panihans/true-randomness-mainboard/README.txt

rename the directory to 'delta x mainboard' or stm32cubeide import will fail
