panihans/true-randomness-mainboard/Documentation/bom_with_order_codes.ods

Qty | TME order # | Mouser order # | Farnell Order # | Value | Device | Package
1 | * | * | 1867985 |  | Button
3 | LL-S192BC-B4-1B | 710-150060BS75000 | 2322069 |  | Blue LED | 0603
3 | FYLS-0603URC | 710-150060SS75000 | 2322072 |  | Red LED | 0603
1 | CRCW0805280RFKTABC | 667-ERJ-2RKF2800X | 2302574 | 280 | Resistor | 0402
1 | 04023C103KAT2A | 581-0402ZC103KAT2A | 2332546 | 0.01u | Capacitor | 0402
3 | C0603C223K5RAC | 80-C0603C223K5R | 1414625 | 0.022u | Capacitor | 0603
8 | C0402C104K8RAC | 80-C0402C104K8R | 2429351 | 0.1u | Capacitor | 0402
7 | 06035C104K4T2A | 581-06035C104K4 | 1301713 | 0.1u | Capacitor | 0603
1 | 06033C224KAT2A | 581-06035C224KAT2A | 2749808 | 0.22u | Capacitor | 0603
1 | CRCW060312K0FKEA | 71-CRCW0603-1.8K-E3 | 1652854 | 1.8k | Resistor | 0603
2 | AC0603FR-07100RL | 603-AC0603FR-07100RL | 3495223 | 100 | Resistor | 0603
3 | CK1H107M08010VR | 710-865060653010 | 2466235 | 100 µF | Electrolytic capacitor | Ø8x10mm
2 | CRCW0603100KFKEA | 71-CRCW0603-100K-E3 | 1469649 | 100k | Resistor | 0603
4 | 1210B106K500CT | 581-12105C106K4T2A | 2834943 | 10u | Capacitor | 1210
1 | DE1207-15 | 710-7447709150 | 1635944 | 15uH | Inductor | 1210
1 | C0603C105K8RAC | 80-C0603C105K8R | 2522396 | 1u | Capacitor | 0603
1 | 08055C105KAT2A | 581-08055C105K4T2A | 2479893 | 1u | Capacitor | 0805
1 | 0603X225K100CT | 810-C1608X7R1A225K | 2346896 | 2.2u | Capacitor | 0603
3 | CQ0603-2K7-1% | 755-ESR03EZPF2701 | 2694062 | 2.7k | Resistor | 0603
3 | 0603SAF2002T5E | 279-CPF0603F20KC1 | 1527615 | 20k | Resistor | 0603
8 | 7-215079-4 | 571-215079-4 | 1772996 | 215079-4 | Connector | 215079-4
1 | CRCW060324K9FKTABC | 279-CPF0603F24K9C1 | 1527625 | 24.9k | Resistor | 0603
3 | CRCW06033K90FKTABC | 652-CR0603-FX3901ELF | 2908301 | 3.9k | Resistor | 0603
1 | C0603C475K8PAC | 80-C0603C475K8P | 1572625 | 4.7u | Capacitor | 0603
2 | CL21A475KBQNNNE | 810-CGA4J1X7R1H475K2 | 3228181 | 4.7u | Capacitor | 0805
3 | GRM32ER71A476KE15L | 81-GRM32ER71A476KE5L | 1797018 | 47u | Capacitor | 1210
3 | AC0603JR-0756KL | 652-CR0603FX-5602ELF | 2908323 | 56k | Resistor | 0603
1 | * | 710-824011 | 1748616 | 5Vdc | TVS-Diode | SOT23-5L
1 | * | 710-629105150521 | 2470822 | 629105150521 | Micro USB connector
1 | * | 771-BUK6Y10-30PX | 3438512 | BUK6Y10-30P | Power MOSFET | LFPAK56
3 | * | 595-DRV8874QPWPRQ1 | * | DRV8874 | Motor driver | HTSSOP-16
1 | * | 200-FTSH10501LDVK | 2856437 | FTSH-105-01-XXX-DV-K | Programmer connector
1 | * | 595-LMR36520ADDAR | * | LMR36520ADDAR | Switching regulator | HSOIC-8
1 | 67996-206HLF | 649-67996-406HLF | 2751377 | PINHD-2X3 | Pin header | 2x3
2 | * | 634-SI8660BB-B-IU | 3105912 | SI8660BB-IU | Digital isolator | QSOP-16
1 | * | 511-STM32G431KBT6 | 3132405 | STM32G431KB | Microcontroller | LQFP-32
1 | TLV70233DBVR | 595-TLV70233DBVR | 3007784 | TLV702 | Regulator 5V→3.3V | SOT23-5
4 | * | 538-172286-1102 | 2494345 | ULTRA-FIT-2PIN | Molex connector receptacle | 2x1
1 | TSHG8200 | 782-TSHG8200 | 1779682 |  | IR diode | THT
1 | IS471FE | 852-IS471FE | 9707840 |  | IR receiver | THT
8 | AMP-7-215083-4 | 571-215083-4 | 149032 |  | micro match housing | 2x2
8 | 7-215079-4 | 571-215079-4 | 1772996 |  | micro match receptacle | 2x2
1 | 1-880584-2 | 571-880584-4 | 1654804 |  | jumper | 2x1
4 | * | 538-172256-3102 | 3225241 |  | Molex connector housing | 2x1
8 | * | 538-172253-7023 | 3220453 | 16-18awg, tin | Crimp terminal
