panihans/true-randomness-mainboard/Documentation/board.pdf

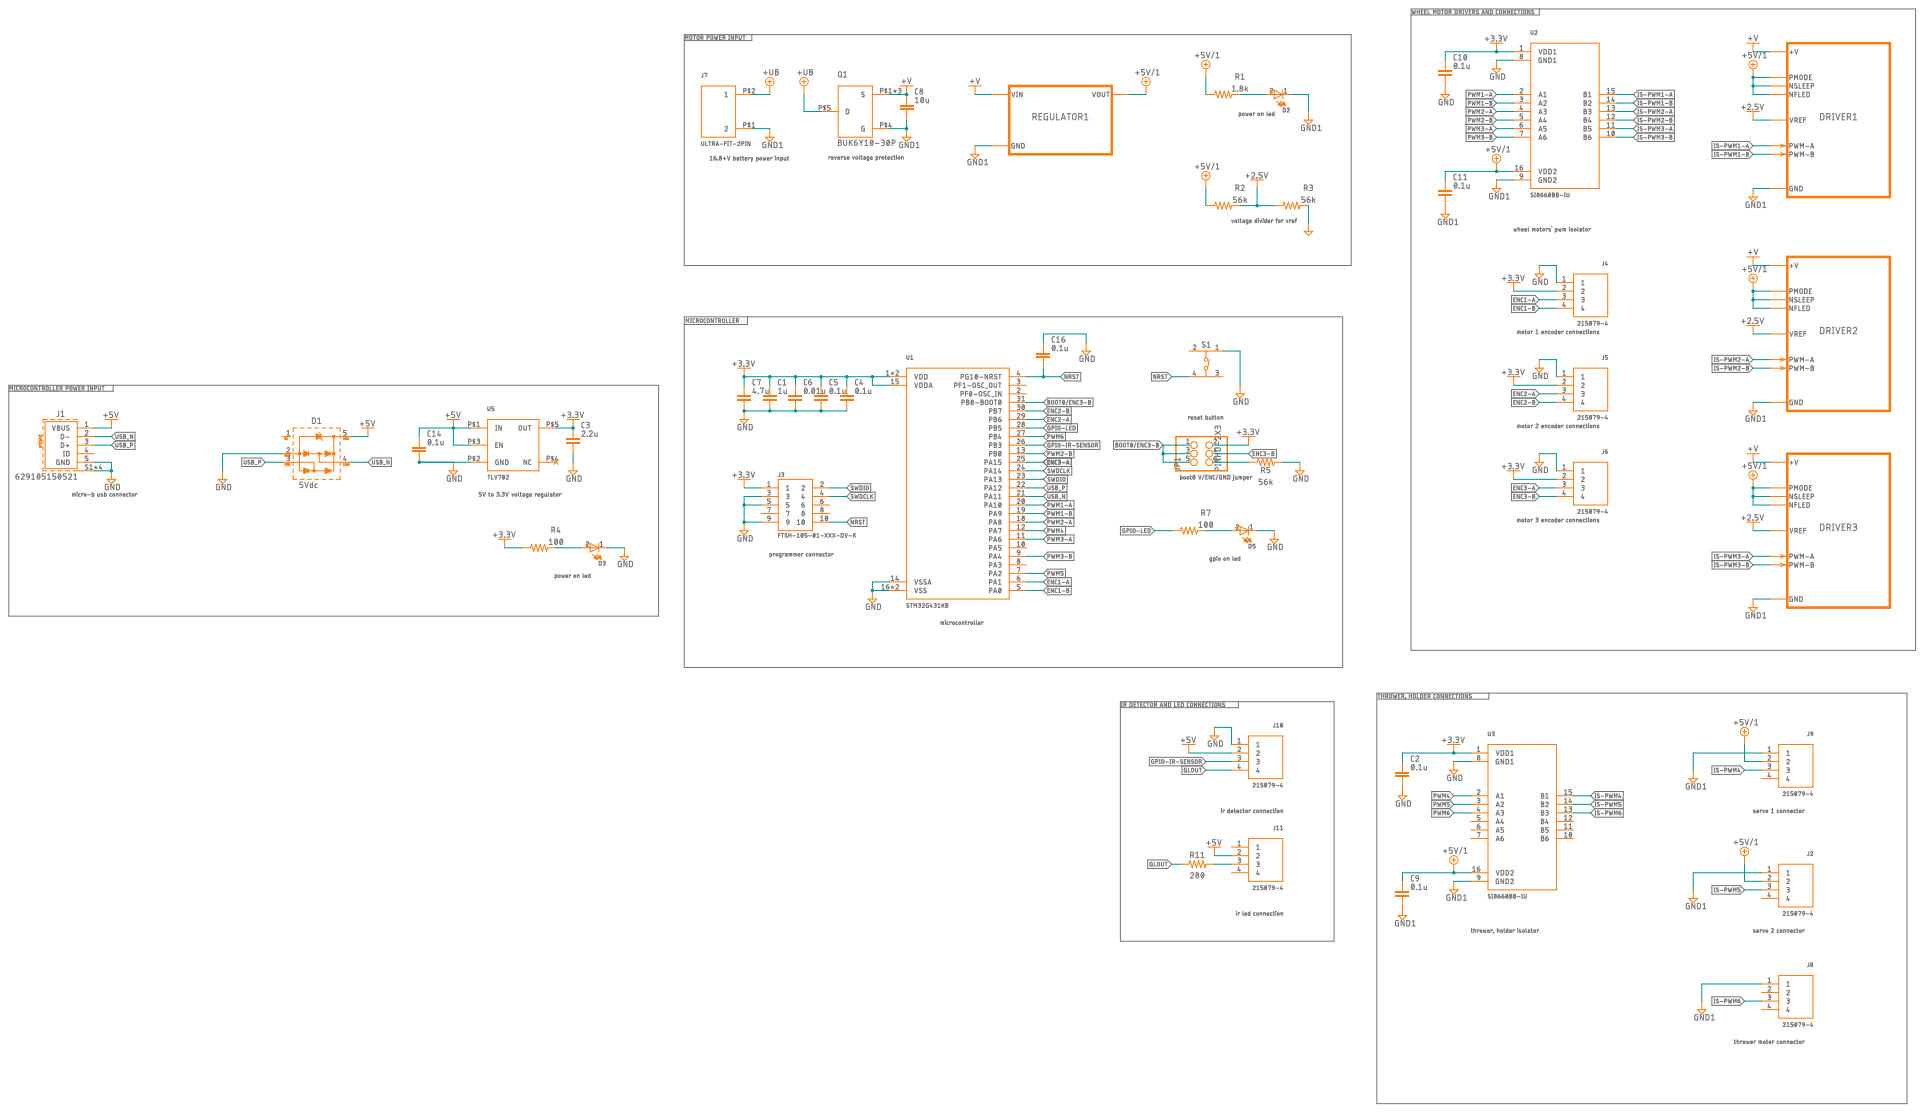
[picture p1: page 1]
