panihans/true-randomness-mainboard/Documentation/regulator.pdf

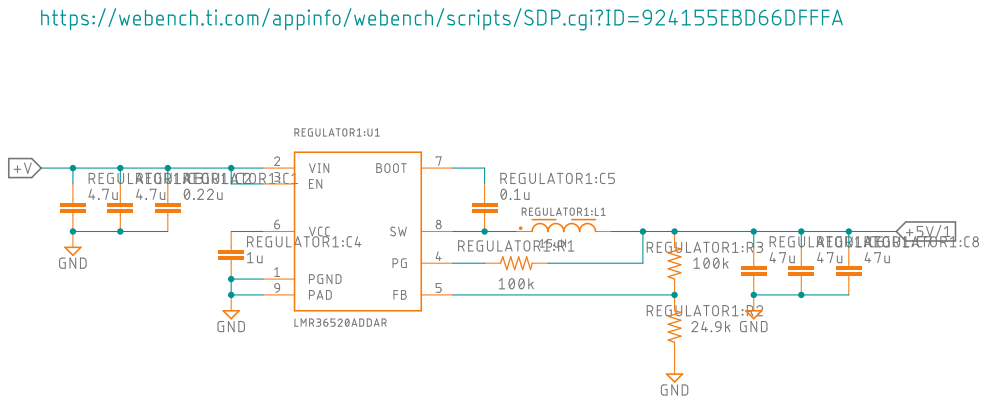
[picture p5: page 1]
