panihans/true-randomness-mainboard/Core/Src/main.c

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
/* Includes ------------------------------------------------------------------*/
#include "main.h"
#include "usb_device.h"

TIM_HandleTypeDef htim1;
TIM_HandleTypeDef htim2;
TIM_HandleTypeDef htim3;
TIM_HandleTypeDef htim4;
TIM_HandleTypeDef htim7;
TIM_HandleTypeDef htim8;
TIM_HandleTypeDef htim15;
TIM_HandleTypeDef htim16;
TIM_HandleTypeDef htim17;

void SystemClock_Config(void);
static void MX_GPIO_Init(void);
static void MX_TIM4_Init(void);
static void MX_TIM8_Init(void);
static void MX_TIM15_Init(void);
static void MX_TIM16_Init(void);
static void MX_TIM1_Init(void);
static void MX_TIM2_Init(void);
static void MX_TIM3_Init(void);
static void MX_TIM7_Init(void);
static void MX_TIM17_Init(void);
/* USER CODE BEGIN 0 */

typedef struct Command {
	float motor1;
	float motor2;
	float motor3;
	float thrower;
	float servo;
	int32_t ir;
	float pGain;
	float iGain;
	float dGain;
	int32_t pid_type;
	int32_t delimiter;
} Command;

Command command, feedback;

volatile uint8_t command_received = 0;
volatile uint8_t command_received_ticker = 0;

volatile float pGain, iGain, dGain = 0;

void CDC_On_Receive(uint8_t *buffer, uint32_t *length) {
	if (*length == sizeof(Command)) {
		memcpy(&command, buffer, sizeof(Command));

		if (command.delimiter == 0xABCABC) {
			command_received = 1;
		}
	}
}

inline void Set_Motor_Speed_f(volatile uint32_t *channel_a,
		volatile uint32_t *channel_b, float motor_speed) {
	if (fabs(0 - motor_speed) > 0.1) {
		if (motor_speed > 0) {
			// forward
			if (motor_speed > 100) {
				motor_speed = 100;
			}
			*channel_a = motor_speed * 65000.0 / 100.0;
			*channel_b = 0;
		} else if (motor_speed < 0) {
			// backward
			if (motor_speed < -100) {
				motor_speed = -100;
			}
			*channel_b = motor_speed * -(65000.0 / 100.0);
			*channel_a = 0;
		}
	} else {
		// stop
		*channel_a = 0;
		*channel_b = 0;
	}
}

inline void Set_Thrower_Speed(volatile uint32_t *channel_a, float thrower_speed) {
	if (thrower_speed > 0) {
		// forward
		if (thrower_speed <= ESC_MAX_SPEED) {
			// 0 to 100 compact range
			*channel_a = thrower_speed * ESC_CO + ESC_MIN_CCR;
		}
	} else {
		// stop
		*channel_a = ESC_IDLE_CCR;
	}
}

inline void Set_Servo_Speed(volatile uint32_t *channel_a, float servo_speed,
		GPIO_PinState ir_status, int32_t ir_control) {
	if (!ir_status || (ir_status && ir_control)) {
		if (servo_speed > 0 && servo_speed <= SERVO_MAX_SPEED) {
			*channel_a = SERVO_IN_MIN_CCR - command.servo * SERVO_CO;
		} else if (command.servo < 0 && servo_speed >= -SERVO_MAX_SPEED) {
			*channel_a = command.servo * -SERVO_CO + SERVO_OUT_MIN_CCR;
		} else {
			*channel_a = 0;
		}
	}
}

Motor motor1;
Motor motor2;
Motor motor3;

inline void Calculate_PID(Motor *motor) {
// based on "PID Without a PhD" by Tim Wescott
// https://www.embeddedrelated.com/showarticle/943.php
	if (motor->target_speed > 0.1 || motor->target_speed < -0.1) {
		float pTerm, iTerm, dTerm;
//		if (command.pid_type == 0) {
//			pGain = 1;
//			iGain = 0.005;
//			dGain = 5;
//		} else {
//			pGain = 1;
//			iGain = 0.001;
//			dGain = 10;
//		}
		pGain = command.pGain;
		iGain = command.iGain;
		dGain = command.dGain;

		int error = 0;
		if (command.pid_type == 0) {
			error = motor->target_speed - motor->cur_enc_speed;
		} else {
			error = motor->target_speed - motor->enc_speed_hist_avg;
		}
		pTerm = error * pGain;

		motor->err_sum += error;
		motor->err_sum = clamp(-1000, 1000, motor->err_sum);
		iTerm = iGain * motor->err_sum;

		dTerm = dGain * (motor->prev_speed - motor->cur_enc_speed);
		motor->prev_speed = motor->cur_enc_speed;
		motor->cur_speed = motor->cur_speed + pTerm + iTerm + dTerm;
		motor->cur_speed = clamp(-100, 100, motor->cur_speed);
	} else {
		motor->cur_speed = 0;
	}
}

inline int Calculate_Encoder_Diff(uint16_t prev_pos, uint16_t cur_pos) {
	int diff = 0;
	if (prev_pos > ENCODER_QUADRANT_3 && cur_pos < ENCODER_QUADRANT) {
		// encoder counter overflow from high to low
		diff = 65535 - prev_pos + cur_pos;
	} else if (prev_pos < ENCODER_QUADRANT && cur_pos > ENCODER_QUADRANT_3) {
		// encoder counter overflow from low to high
		diff = -65535 + cur_pos - prev_pos;
	} else {
		// encoder didn't overflow
		diff = cur_pos - prev_pos;
	}
	return diff;	// clamp(-200, 200, diff) / 2;
}

void Handle_Encoder(Motor *motor, uint16_t count) {
	motor->cur_pos = count;
	motor->cur_enc_speed = Calculate_Encoder_Diff(motor->prev_pos,
			motor->cur_pos);
	motor->prev_pos = motor->cur_pos;

	motor->enc_speed_hist[motor->enc_speed_hist_cnt] = motor->cur_enc_speed;
	if (motor->enc_speed_hist_cnt >= 9) {
		motor->enc_speed_hist_cnt = 0;
	} else {
		motor->enc_speed_hist_cnt += 1;
	}

	int sum = 0;
	for (int i = 0; i < 10; i++) {
		sum += motor->enc_speed_hist[i];
	}
	motor->enc_speed_hist_avg = sum / 10;
}

/* USER CODE END 0 */

/**
 * @brief  The application entry point.
 * @retval int
 */
int main(void) {
	/* MCU Configuration--------------------------------------------------------*/

	/* Reset of all peripherals, Initializes the Flash interface and the Systick. */
	HAL_Init();

	/* Configure the system clock */
	SystemClock_Config();

	/* Initialize all configured peripherals */
	MX_GPIO_Init();
	MX_TIM4_Init();
	MX_TIM8_Init();
	MX_TIM15_Init();
	MX_TIM16_Init();
	MX_TIM1_Init();
	MX_TIM2_Init();
	MX_TIM3_Init();
	MX_TIM7_Init();
	MX_TIM17_Init();
	MX_USB_Device_Init();
	/* USER CODE BEGIN 2 */

	HAL_TIM_Encoder_Start(&htim2, TIM_CHANNEL_1 | TIM_CHANNEL_2);
	HAL_TIM_Encoder_Start(&htim4, TIM_CHANNEL_1 | TIM_CHANNEL_2);
	HAL_TIM_Encoder_Start(&htim8, TIM_CHANNEL_1 | TIM_CHANNEL_2);

	HAL_TIM_PWM_Start(&htim1, TIM_CHANNEL_1);
	HAL_TIM_PWM_Start(&htim1, TIM_CHANNEL_2);
	HAL_TIM_PWM_Start(&htim1, TIM_CHANNEL_3);
	TIM1->CCR1 = 0;
	TIM1->CCR2 = 0;
	TIM1->CCR3 = 0;

	HAL_TIM_PWM_Start(&htim3, TIM_CHANNEL_1);
	HAL_TIM_PWM_Start(&htim3, TIM_CHANNEL_2);
	HAL_TIM_PWM_Start(&htim3, TIM_CHANNEL_3);
	TIM3->CCR1 = 0;
	TIM3->CCR2 = 0;
	TIM3->CCR3 = 0;

	HAL_TIM_PWM_Start(&htim15, TIM_CHANNEL_1);
	HAL_TIM_PWM_Start(&htim16, TIM_CHANNEL_1);
	HAL_TIM_PWM_Start(&htim17, TIM_CHANNEL_1);
	TIM15->CCR1 = 0;
	TIM16->CCR1 = ESC_IDLE_CCR;
	TIM17->CCR1 = 0;

	HAL_TIM_Base_Start_IT(&htim7);

	CoreDebug->DEMCR |= CoreDebug_DEMCR_TRCENA_Msk;
	DWT->CYCCNT = 0;
	DWT->CTRL |= DWT_CTRL_CYCCNTENA_Msk;

	/* USER CODE END 2 */

	/* Infinite loop */
	/* USER CODE BEGIN WHILE */
	while (1) {
		/* USER CODE END WHILE */

		/* USER CODE BEGIN 3 */
		if (command_received == 1) {
			command_received = 0;
			command_received_ticker = 140;

			// toggle led
			HAL_GPIO_TogglePin(GPIOB, GPIO_PIN_5);

			feedback.ir = HAL_GPIO_ReadPin(GPIOB, GPIO_PIN_3);

			if (fabs(0 - command.motor1) < 0.1) {
				motor1.err_sum = 0;
			}
			if (fabs(0 - command.motor2) < 0.1) {
				motor2.err_sum = 0;
			}
			if (fabs(0 - command.motor3) < 0.1) {
				motor3.err_sum = 0;
			}
			motor1.target_speed = command.motor1;
			motor2.target_speed = command.motor2;
			motor3.target_speed = command.motor3;
//			pGain = command.pGain;
//			iGain = command.iGain;
//			dGain = command.dGain;

			Set_Thrower_Speed(&(TIM16->CCR1), command.thrower);

			Set_Servo_Speed(&(TIM17->CCR1), command.servo,
					HAL_GPIO_ReadPin(GPIOB, GPIO_PIN_3), command.ir);

			CDC_Transmit_FS(&feedback, sizeof(feedback));
		}
	}
	/* USER CODE END 3 */
}

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
/* USER CODE BEGIN 4 */
void HAL_TIM_PeriodElapsedCallback(TIM_HandleTypeDef *htim) {
//	unsigned long t1 = DWT->CYCCNT;

	Handle_Encoder(&motor1, TIM2->CNT);
	Handle_Encoder(&motor2, TIM4->CNT);
	Handle_Encoder(&motor3, TIM8->CNT);
	if (command.pid_type == 0) {
		feedback.motor1 = motor1.cur_enc_speed;
		feedback.motor2 = motor2.cur_enc_speed;
		feedback.motor3 = motor3.cur_enc_speed;
	} else {
		feedback.motor1 = motor1.enc_speed_hist_avg;
		feedback.motor2 = motor2.enc_speed_hist_avg;
		feedback.motor3 = motor3.enc_speed_hist_avg;
	}

	Calculate_PID(&motor1);
	Calculate_PID(&motor2);
	Calculate_PID(&motor3);
	Set_Motor_Speed_f(&(TIM1->CCR2), &(TIM1->CCR3), motor1.cur_speed);
	Set_Motor_Speed_f(&(TIM1->CCR1), &(TIM3->CCR3), motor2.cur_speed);
	Set_Motor_Speed_f(&(TIM3->CCR1), &(TIM3->CCR2), motor3.cur_speed);

// servo stopper
	if (HAL_GPIO_ReadPin(GPIOB, GPIO_PIN_3) && !command.ir) {
		TIM17->CCR1 = 0;
	}

// timeout
	if (command_received_ticker > 0) {
		command_received_ticker -= 1;
	} else {
		// stop wheels
		TIM1->CCR1 = 0;
		TIM1->CCR2 = 0;
		TIM1->CCR3 = 0;
		TIM3->CCR1 = 0;
		TIM3->CCR2 = 0;
		TIM3->CCR3 = 0;

		// stop thrower
		TIM16->CCR1 = ESC_IDLE_CCR;

		// stop servo
		TIM17->CCR1 = 0;
	}
//	unsigned long t2 = DWT->CYCCNT;
//	unsigned long diff = t2 - t1;
}
/* USER CODE END 4 */
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
