panihans/true-randomness-mainboard/delta x mainboard.ioc

Mcu.UserName=STM32G431KBTx
PA0.Signal=S_TIM2_CH1
PA1.Signal=S_TIM2_CH2
PA10.Signal=S_TIM1_CH3
PA11.Signal=USB_DM
PA12.Signal=USB_DP
PA13.Signal=SYS_JTMS-SWDIO
PA14.Signal=SYS_JTCK-SWCLK
PA15.Signal=S_TIM8_CH1
PA2.Signal=S_TIM15_CH1
PA4.Signal=S_TIM3_CH2
PA6.Signal=S_TIM3_CH1
PA7.Signal=S_TIM17_CH1
PA8.Signal=S_TIM1_CH1
PA9.Signal=S_TIM1_CH2
PB0.Signal=S_TIM3_CH3
PB3.Signal=GPIO_Input
PB4.Signal=S_TIM16_CH1
PB5.Signal=GPIO_Output
PB6.Signal=S_TIM4_CH1
PB7.Signal=S_TIM4_CH2
PB8-BOOT0.Signal=S_TIM8_CH2
