panihans/true-randomness-mainboard/Core/Inc/main.h

#define MOTORS_MIN_CCR 20000
#define MOTORS_MAX_CCR 65000
#define MOTORS_MAX_SPEED 100
#define MOTORS_CO ((MOTORS_MAX_CCR - MOTORS_MIN_CCR) / MOTORS_MAX_SPEED)
#define ESC_IDLE_CCR 4000
#define ESC_MIN_CCR 4200
#define ESC_MAX_CCR 7000
#define ESC_MAX_SPEED 100
#define ESC_CO ((ESC_MAX_CCR - ESC_MIN_CCR) / ESC_MAX_SPEED)
#define SERVO_IN_MIN_CCR 4700
#define SERVO_OUT_MIN_CCR 5000
#define SERVO_MAX_SPEED 100
#define SERVO_CO (400/SERVO_MAX_SPEED)
#define ENCODER_MAX 65535
#define ENCODER_QUADRANT (ENCODER_MAX / 4)
#define ENCODER_QUADRANT_3 (ENCODER_QUADRANT * 3)
