panihans/true-randomness-mainboard/(commit log)

2020-12-03 updated timer configs, added receive/feedback structs
2020-12-11 apb and timer frequencies changed
2020-12-14 no pid pwm motor control, ~1s timeout to turn off motors
2020-12-30 function for motor speed setting
2020-12-30 fixed motor timeout
2020-12-30 esc control unfinished
2020-12-31 esc speed control
2020-12-31 swapped motor polarity by swapping timers
    [main.c]
2020-12-31 servo and ir control
2020-12-31 unfinished proportional part of pid
2021-01-01 encoder math with mod
2021-01-01 pid testing
2021-01-02 working pid, cleaned up test code
2021-01-04 more precise pid option
2021-01-07 precise pid fix and calibration, removed thrower feedback
    [delta x mainboard.ioc, main.c, main.h]
2021-01-22 float thrower and servo speeds
2021-01-25 pid reset when 0, added readme
    [main.c]
2021-01-26 pid constants over usb
2021-01-27 bom, doc update
    [bom_farnell.ods, bom_with_order_codes.ods]
